cheatsnake/dragy-oss/src/accelerometer.h

#ifndef ACCELEROMETER_H
#define ACCELEROMETER_H

void initAccelerometer();
void startCalibration();
bool isCalibrationInProgress();
void abortCalibration();
void updateAccelerometer();
void armSleepWakeup();
bool isMotionActive();
void notifyLaunchDetected();
bool detectLaunchStart(unsigned long &launchStartMillis);
float getFilteredAccelerationG();
bool getAccelerationAtMillis(unsigned long timestampMillis, float &accelerationG);

#endif
